BONILLAJABA/DISENO-Y-MONTAJE-DE-UN-CARRITO-SEGUIDOR-DE-LINEA/README.md

# DISENO-Y-MONTAJE-DE-UN-CARRITO-SEGUIDOR-DE-LINEA
