BONILLAJABA/DISENO-Y-MONTAJE-DE-UN-CARRITO-SEGUIDOR-DE-LINEA/SENSORES/PUENTEHSEGUI.PDF

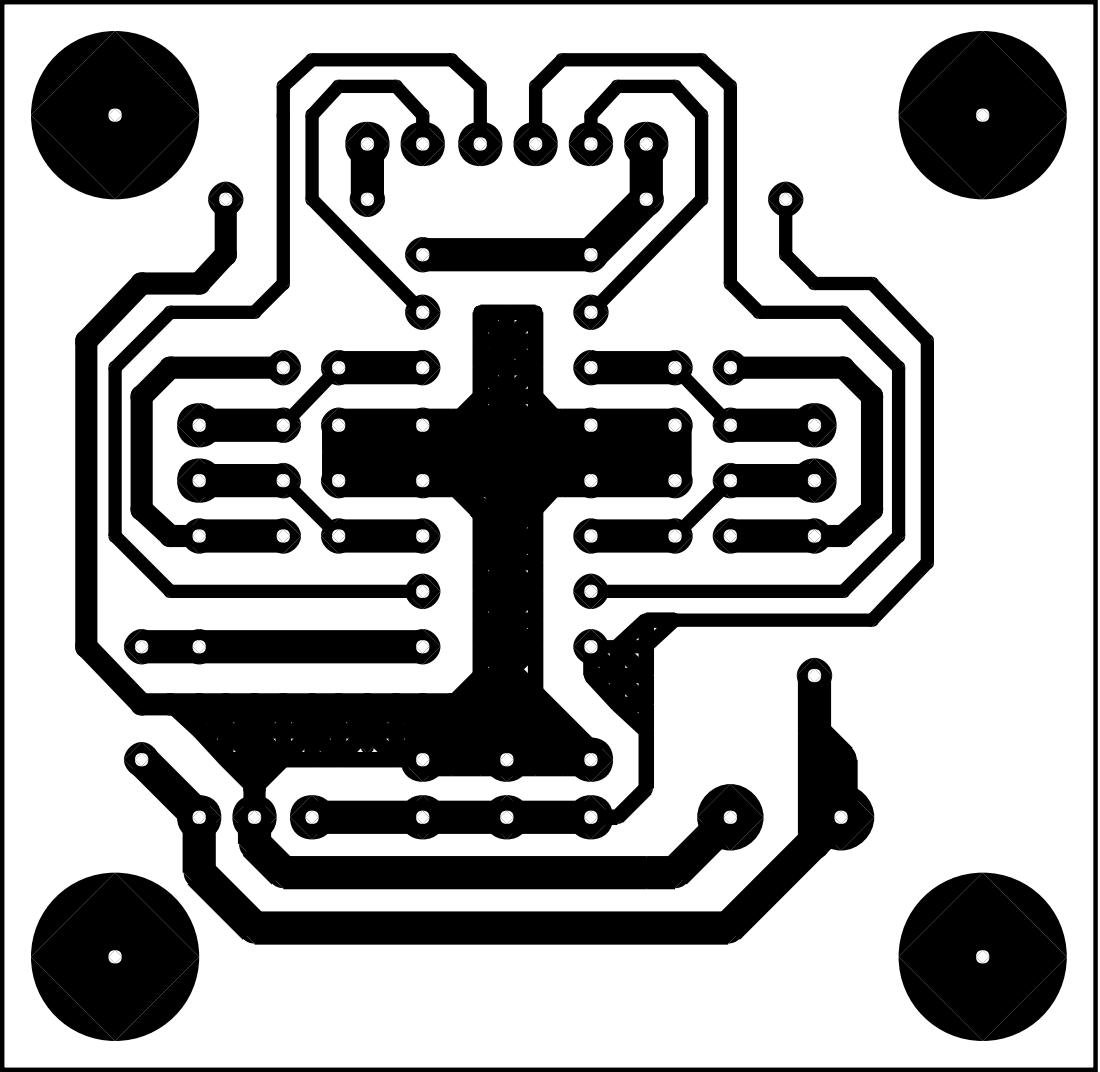
[picture p7: page 1]
