BONILLAJABA/DISENO-Y-MONTAJE-DE-UN-CARRITO-SEGUIDOR-DE-LINEA/SENSORES/CNY70.brd

## EAGLE design SENSORES/CNY70.brd (2019-06-22)

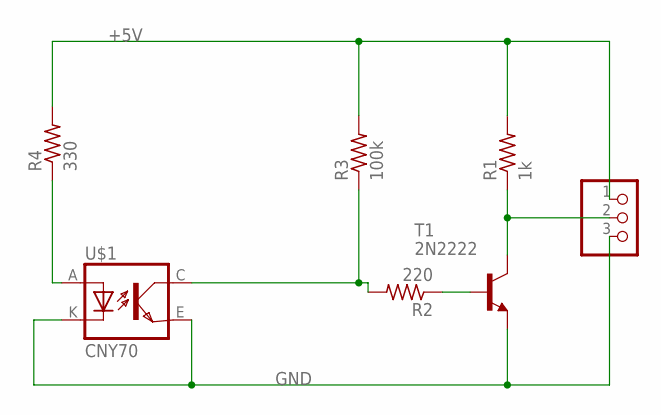
[picture p8: schematic CNY70.sch]

Parts:
JP1: PINHD-1X3; 1X03
R1: 1k; 0207/10
R2: 220; 0207/10
R3: 100k; 0207/10
R4: 330; 0207/10
T1: 2N2222; TO92-EBC-OVAL
U$1: CNY70; 4

Connections:
+5V: JP1.1, R1.2, R3.2, R4.2
GND: JP1.3, T1.E, U$1.E (EMI), U$1.K (C)
unnamed: R2.2, R3.1, U$1.C (COL)
unnamed: R2.1, T1.B
unnamed: R4.1, U$1.A
unnamed: JP1.2, R1.1, T1.C

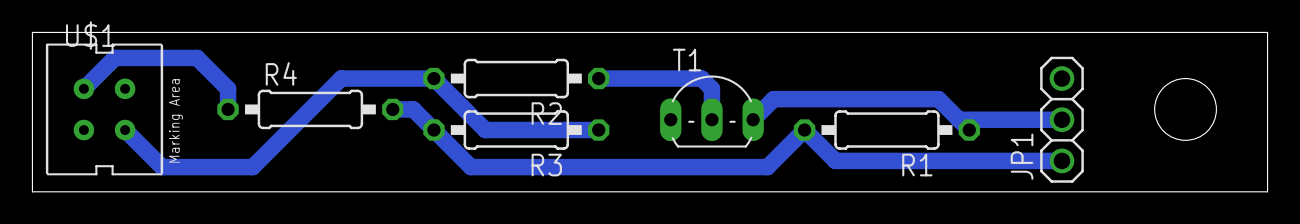
[picture p9: board CNY70.brd from above]

Board: 2 copper layers, 76.2 x 9.8 mm, 7 parts (0 on the bottom side), 6 nets.
